revk/ESP32-Flasher/PCB/Flasher2/README.md

# Flasher2

## Trademark

This project is subject to the licence in the LICENCE file, and even if that says it is an open source project, you cannot sell boards or cases bearing the Andrews & Arnold Ltd name, the A&A logo, the registered trademark AJK logo or other registered trademarks, or any GS1 allocated EANs/barcode assigned to Andrews & Arnold Ltd.

## PCB Designs

These files are for use with [KiCAD](https://www.kicad.org).

- [Flasher](Flasher.kicad_pro)

## 3D

3D case designs are normally automatically created from the PCB so as to ensure correct details and placement of apertures, etc.

|Design|Bottom|Top|Combined|
|---|---|---|---|
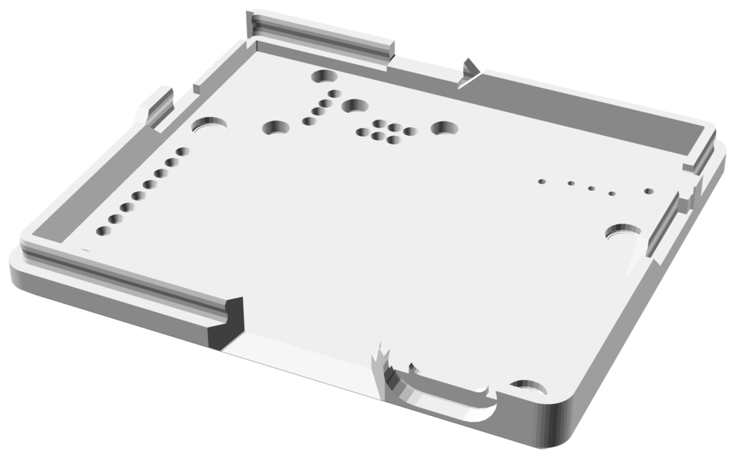
[picture p3: PCB/Flasher2/FlasherB.png]
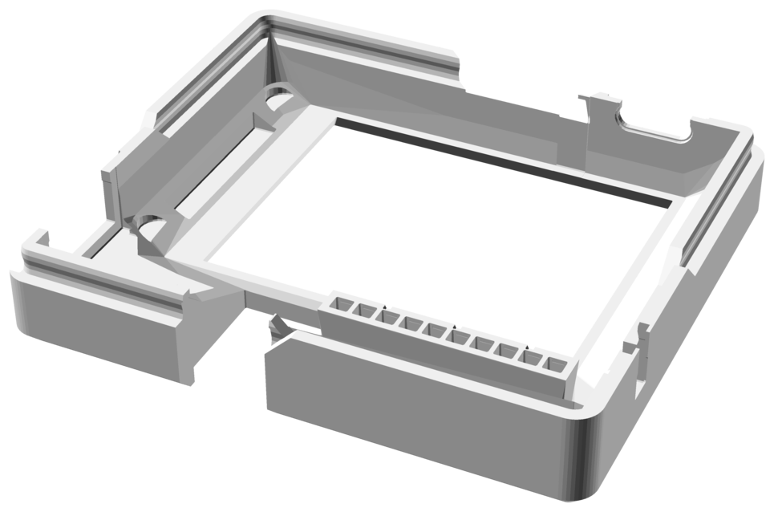
[picture p4: PCB/Flasher2/FlasherT.png]
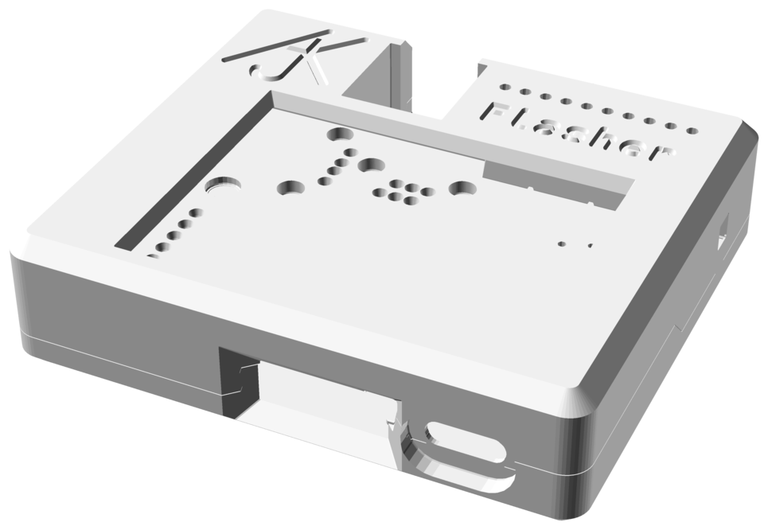
[picture p5: PCB/Flasher2/FlasherC.png]
|Flasher||||

## PCB Images

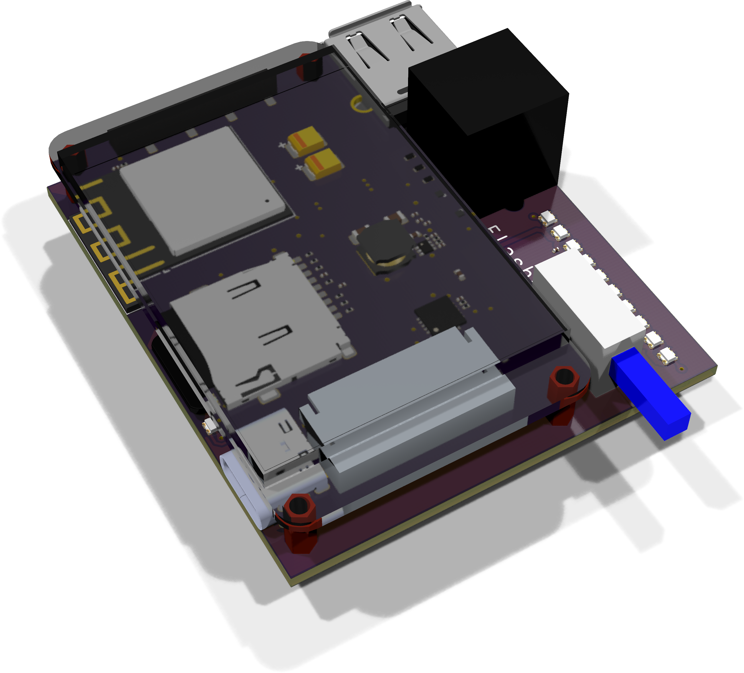
[picture p6: PCB/Flasher2/Flasher-90.png]
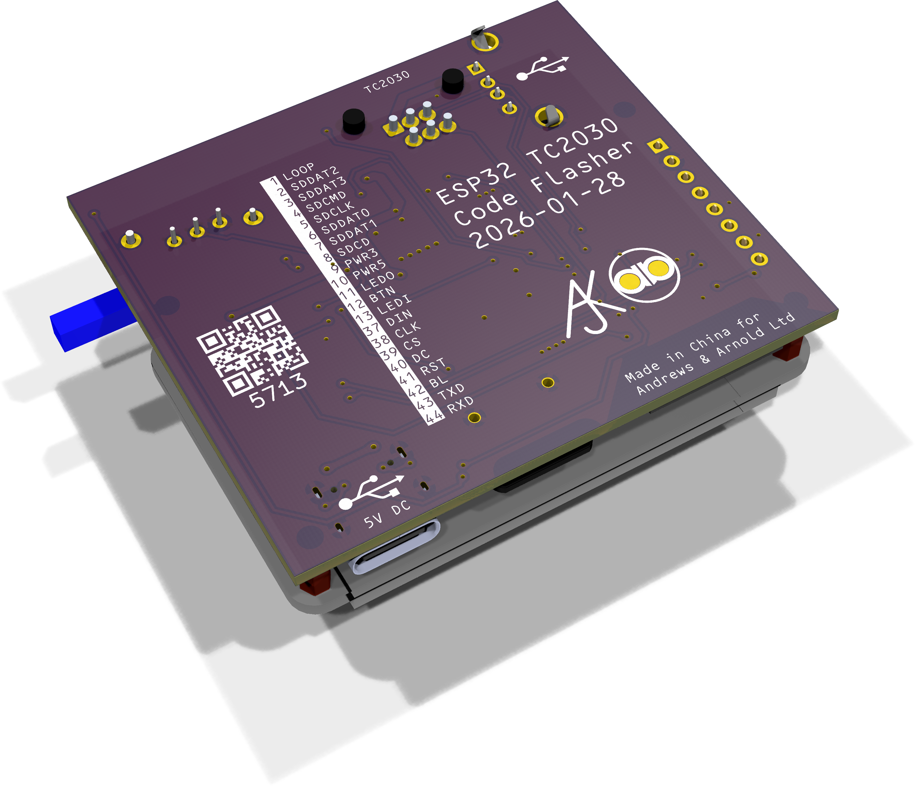
[picture p7: PCB/Flasher2/Flasher-bottom.png]

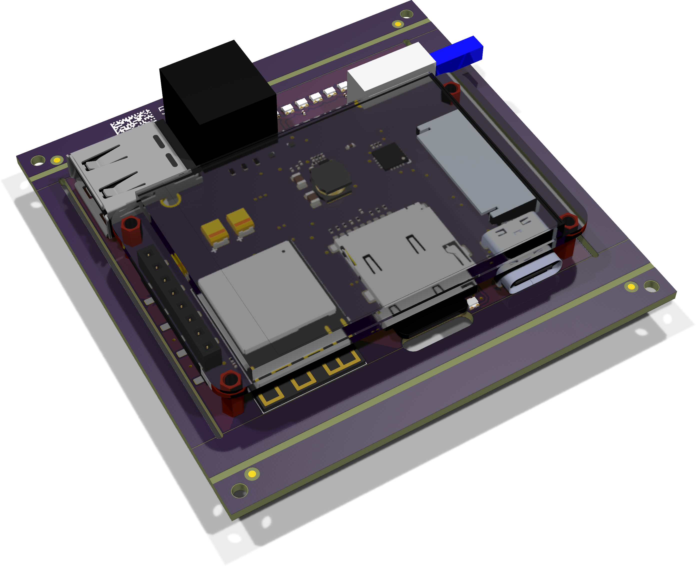
[picture p8: PCB/Flasher2/Flasher-panel.png]
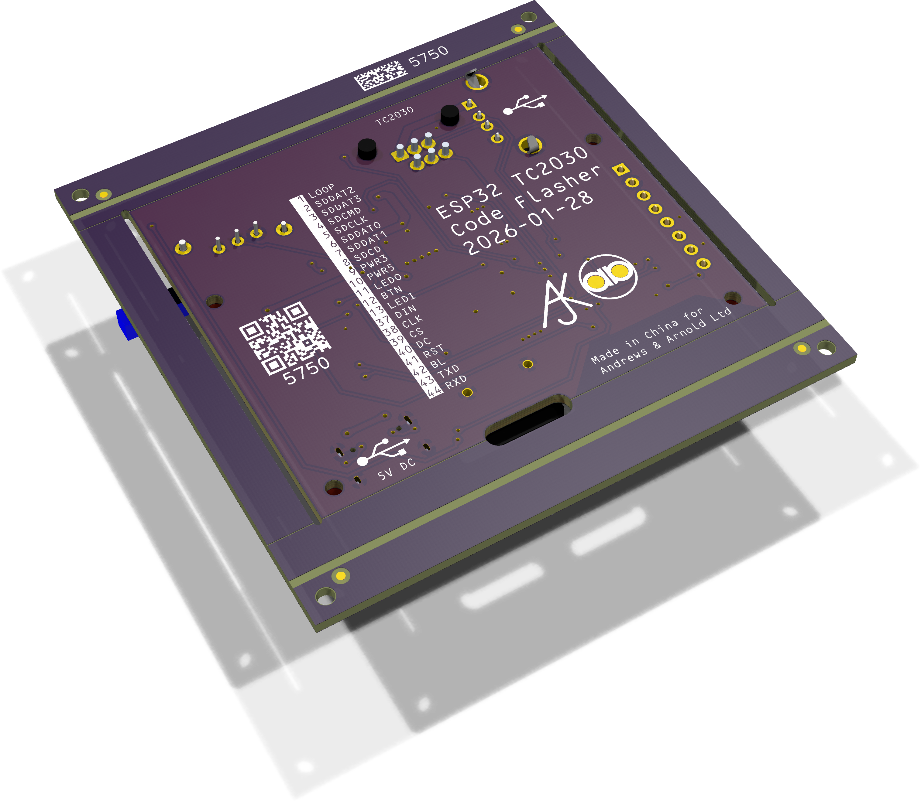
[picture p9: PCB/Flasher2/Flasher-panel-bottom.png]


---

*Auto generated README.md 2026-01-28T10:23:43*
