revk/ESP32-Flasher/PCB/Flasher/FlasherB.stl

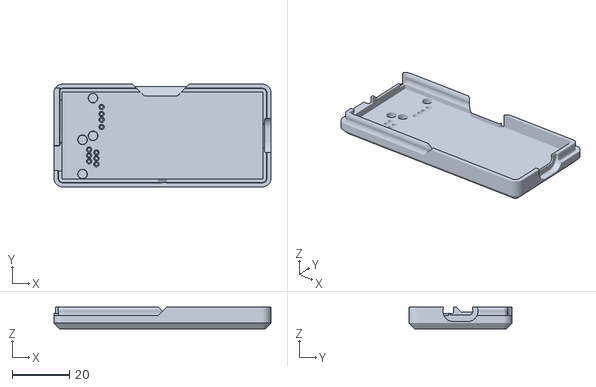
[picture p17: CAD file, 2026-01-18]
PCB/Flasher/FlasherB.stl
76.0 x 36.0 x 7.60
