revk/ESP32-Flasher/PCB/Flasher2/FlasherT.stl

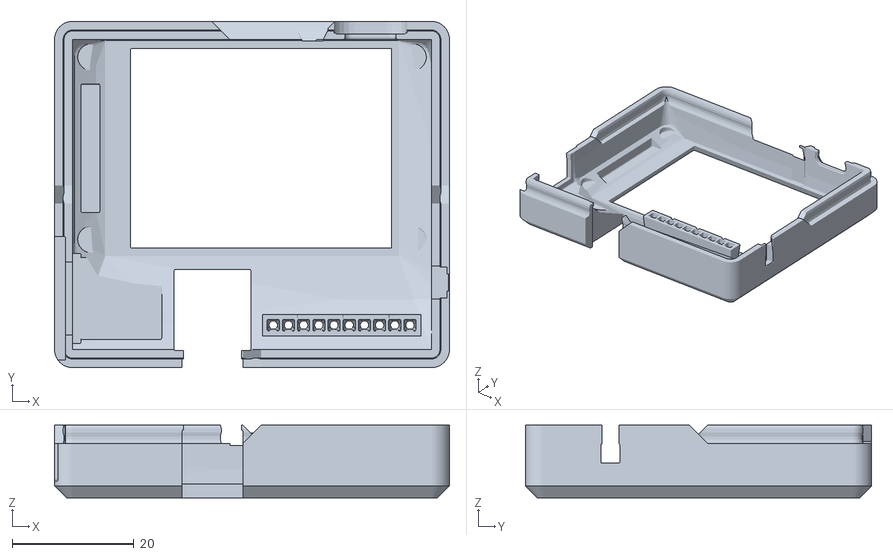
[picture p18: CAD file, 2026-01-28]
PCB/Flasher2/FlasherT.stl
65.0 x 57.0 x 12.0
