revk/ESP32-Flasher/PCB/Flasher/FlasherT.stl

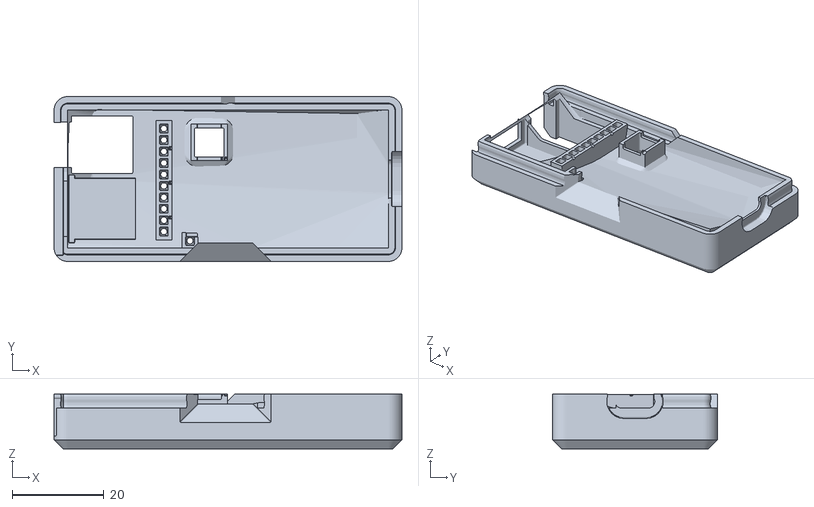
[picture p19: CAD file, 2026-01-18]
PCB/Flasher/FlasherT.stl
76.0 x 36.0 x 12.0
