revk/ESP32-Flasher/(list of files, cad)

Other CAD files:
PCB/Flasher/FlasherC.scad
PCB/Flasher/FlasherT.scad
PCB/Flasher2/FlasherB.scad
PCB/Flasher2/FlasherC.scad
PCB/Flasher2/FlasherT.scad
