revk/ESP32-Flasher/PCB/Flasher2/Flasher.kicad_pcb

## KiCad design PCB/Flasher2/Flasher.kicad_pcb (2026-01-28)

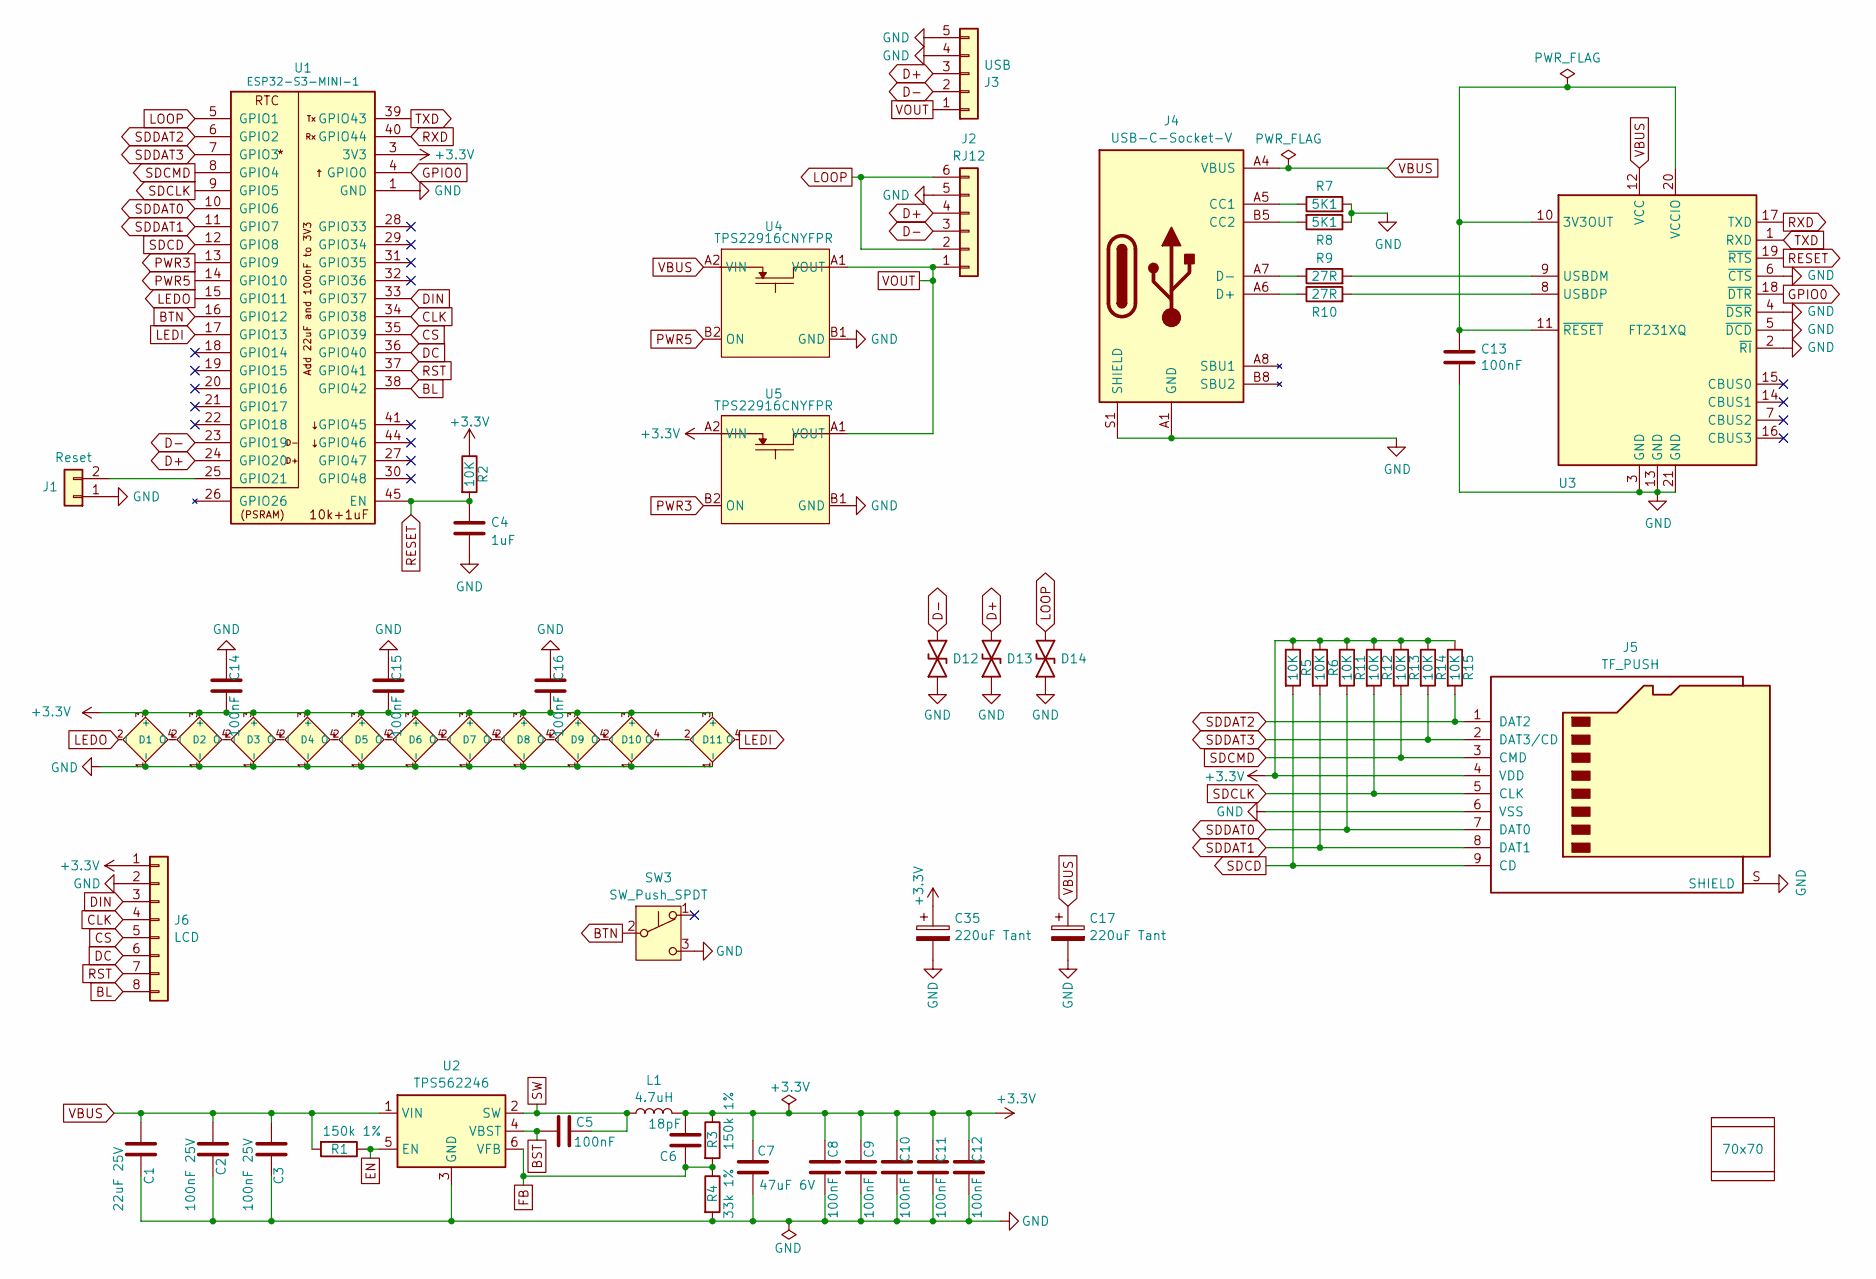
[picture p20: schematic Flasher.kicad_sch]

Parts:
C1: 22uF 25V; C_0805; MPN C45783
C2, C3: 100nF 25V; C_0402; MPN C56392
C4: 1uF; C_0201
C5, C8, C9, C10, C11, C12, C14, C15, C16: 100nF; C_0201; MPN C76934
C6: 18pF; C_0201; MPN C62164
C7: 47uF 6V; C_0805; MPN C16780
C13: 100nF; C_0201
C17, C35: 220uF Tant; CP_EIA-3528-21_Kemet-B; MPN C122649
D1, D2, D3, D4, D5, D6, D7, D8, D9, D10: XL-1010RGBC-WS2812B; SMD1615; MPN C5349954
D11: XL-1010RGBC-WS2812B; SMD1615-Side; MPN C5349954
D12, D13, D14: DFN1006-2L; MPN C5137770
J1: Reset; AA-Pad
J2: RJ12; RJ12_Horizontal; MPN C77859
J3: USB; USB_A_Horizontal; MPN C720525
J4: USB-C-Socket-V; USB-C-Socket-H; MPN C709357
J5: TF_PUSH; MPN C393941
J6: LCD; LCD2; MPN C42380985
L1: 4.7uH; L_5x5; MPN C307876
PCB1: 70x70; PCB7070
R1, R3: 150k 1%; R_0201; MPN C310173
R2, R5, R6, R11, R12, R13, R14, R15: 10K; R_0201; MPN C106225
R4: 33k 1%; R_0201; MPN C320835
R7, R8: 5K1; R_0201; MPN C270344
R9, R10: 27R; R_0201; MPN C273295
SW3: SW_Push_SPDT; PS-12E15; MPN C2884730
U1: ESP32-S3-MINI-1; MPN C3013941
U2: TPS562246; SOT-5x3-6; MPN C41833479
U3: FT231XQ; QFN-20-1EP_4x4mm_P0.5mm_EP2.5x2.5mm; Part No FT231XQ
U4, U5: TPS22916CNYFPR; WCSP-4-0.78x0.78; MPN C2655476
V2, V3: VCUT70N

Connections:
+3.3V: C6.2, C7.1, C8.2, C9.2, C10.2, C11.2, C12.2, C14.1, C15.1, C16.1, C35.1, D1.3 (+), D2.3 (+), D3.3 (+), D4.3 (+), D5.3 (+), D6.3 (+), D7.3 (+), D8.3 (+), D9.3 (+), D10.3 (+), D11.3 (+), J5.4 (VDD), J6.1, L1.2, R2.1, R3.1, R5.1, R6.1, R11.1, R12.1, R13.1, R14.1, R15.1, U1.3 (3V3), U5.A2 (VIN)
BL: J6.8, U1.38 (GPIO42)
BST: C5.1, U2.4 (VBST)
BTN: SW3.2 (B), U1.16 (GPIO12)
CLK: J6.4, U1.34 (GPIO38)
CS: J6.5, U1.35 (GPIO39)
D+: D13.2, J2.4, J3.3, U1.24 (GPIO20)
D-: D12.2, J2.3, J3.2, U1.23 (GPIO19)
DC: J6.6, U1.36 (GPIO40)
DIN: J6.3, U1.33 (GPIO37)
EN: R1.1, U2.5 (EN)
FB: C6.1, R3.2, R4.1, U2.6 (VFB)
GND: C1.2, C2.2, C3.2, C4.2, C7.2, C8.1, C9.1, C10.1, C11.1, C12.1, C13.2, C14.2, C15.2, C16.2, C17.2, C35.2, D1.1 (-), D2.1 (-), D3.1 (-), D4.1 (-), D5.1 (-), D6.1 (-), D7.1 (-), D8.1 (-), D9.1 (-), D10.1 (-), D11.1 (-), D12.1, D13.1, D14.1, J1.1, J2.5, J3.4, J3.5, J4.A1 (GND), J4.A12 (GND), J4.B1 (GND), J4.B12 (GND), J4.S1 (SHIELD), J5.6 (VSS), J5.S (SHIELD), J6.2, R4.2, R7.2, R8.1, SW3.3 (C), U1.1 (GND), U1.2 (GND), U1.42 (GND), U1.43 (GND), U1.46 (GND), U1.47 (GND), U1.48 (GND), U1.49 (GND), U1.50 (GND), U1.51 (GND), U1.52 (GND), U1.53 (GND), U1.54 (GND), U1.55 (GND), U1.56 (GND), U1.57 (GND), U1.58 (GND), U1.59 (GND), U1.60 (GND), U1.61 (GND), U1.62 (GND), U1.63 (GND), U1.64 (GND), U1.65 (GND), U2.3 (GND), U3.2 (~RI), U3.3 (GND), U3.4 (~DSR), U3.5 (~DCD), U3.6 (~CTS), U3.13 (GND), U3.21 (GND), U4.B1 (GND), U5.B1 (GND)
GPIO0: U1.4 (GPIO0), U3.18 (~DTR)
LEDI: D11.4 (O), U1.17 (GPIO13)
LEDO: D1.2 (I), U1.15 (GPIO11)
LOOP: D14.2, J2.2, J2.6, U1.5 (GPIO1)
unnamed: D1.4 (O), D2.2 (I)
unnamed: D2.4 (O), D3.2 (I)
unnamed: D3.4 (O), D4.2 (I)
unnamed: D4.4 (O), D5.2 (I)
unnamed: D5.4 (O), D6.2 (I)
unnamed: D6.4 (O), D7.2 (I)
unnamed: D7.4 (O), D8.2 (I)
unnamed: D8.4 (O), D9.2 (I)
unnamed: D9.4 (O), D10.2 (I)
unnamed: D10.4 (O), D11.2 (I)
unnamed: J1.2, U1.25 (GPIO21)
unnamed: J4.A5 (CC1), R7.1
unnamed: J4.B5 (CC2), R8.2
unnamed: J4.A6 (D+), J4.B6 (D+), R10.1
unnamed: J4.A7 (D-), J4.B7 (D-), R9.1
unnamed: C13.1, U3.10 (3V3OUT), U3.11 (~RESET), U3.20 (VCCIO)
unnamed: R9.2, U3.9 (USBDM)
unnamed: R10.2, U3.8 (USBDP)
PWR3: U1.13 (GPIO9), U5.B2 (ON)
PWR5: U1.14 (GPIO10), U4.B2 (ON)
RESET: C4.1, R2.2, U1.45 (EN), U3.19 (~RTS)
RST: J6.7, U1.37 (GPIO41)
RXD: U1.40 (GPIO44), U3.17 (TXD)
SDCD: J5.9 (CD), R5.2, U1.12 (GPIO8)
SDCLK: J5.5 (CLK), R12.2, U1.9 (GPIO5)
SDCMD: J5.3 (CMD), R13.2, U1.8 (GPIO4)
SDDAT0: J5.7 (DAT0), R11.2, U1.10 (GPIO6)
SDDAT1: J5.8 (DAT1), R6.2, U1.11 (GPIO7)
SDDAT2: J5.1 (DAT2), R15.2, U1.6 (GPIO2)
SDDAT3: J5.2 (DAT3/CD), R14.2, U1.7 (GPIO3)
SW: C5.2, L1.1, U2.2 (SW)
TXD: U1.39 (GPIO43), U3.1 (RXD)
VBUS: C1.1, C2.1, C3.1, C17.1, J4.A4 (VBUS), J4.A9 (VBUS), J4.B4 (VBUS), J4.B9 (VBUS), R1.2, U2.1 (VIN), U3.12 (VCC), U4.A2 (VIN)
VOUT: J2.1, J3.1, U4.A1 (VOUT), U5.A1 (VOUT)

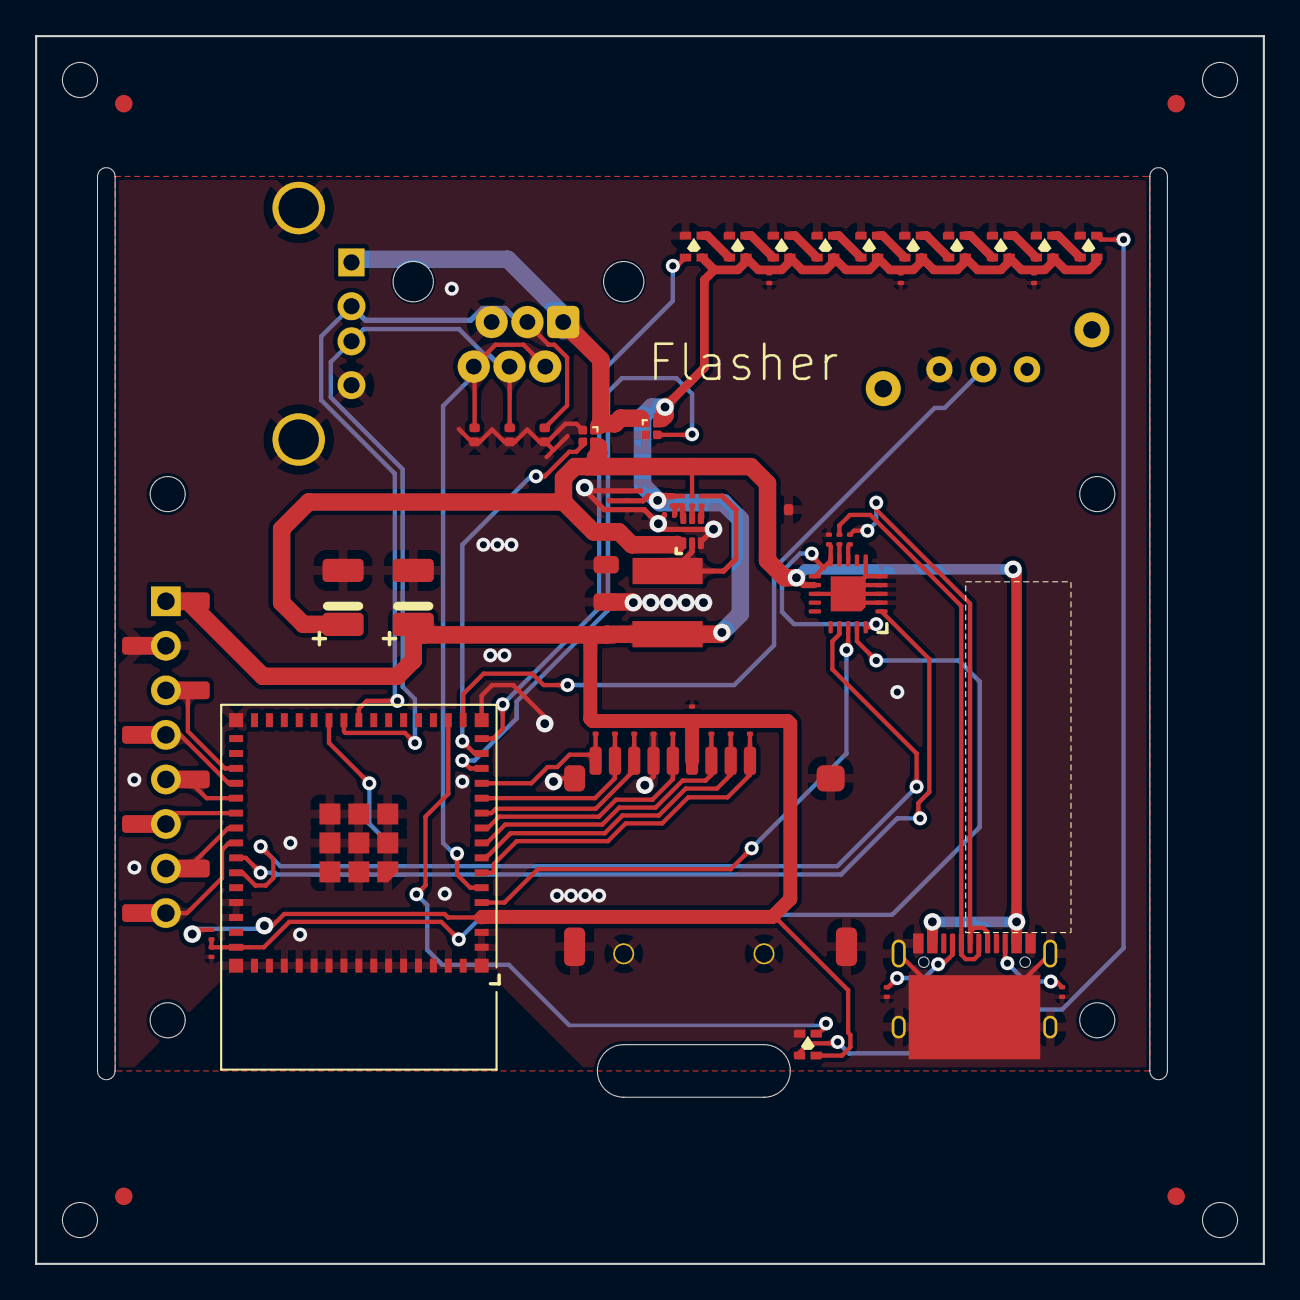
[picture p21: board Flasher.kicad_pcb from above]

Board: 2 copper layers, 70.0 x 70.0 mm, 63 parts (1 on the bottom side), 51 nets.
