revk/ESP32-Flasher/(commit log)

2025-09-13 Start PCb
    [Flasher.kicad_pcb, Flasher.kicad_sch]
2025-09-13 Started placement
    [Flasher.kicad_pcb, Flasher.kicad_sch, bom.csv, designators.csv, positions.csv]
2025-09-13 New tweaks
    [Flasher.kicad_pcb, Flasher.kicad_sch, FlasherB.scad, FlasherB.stl, FlasherT.scad, FlasherT.stl, bom.csv, designators.csv]
2025-09-14 New sockets
    [Flasher.kicad_pcb, Flasher.kicad_sch, bom.csv, designators.csv, positions.csv]
2025-09-14 Board ready
    [Flasher.kicad_pcb, Flasher.kicad_sch, FlasherB.scad, FlasherB.stl, FlasherT.scad, FlasherT.stl, bom.csv, designators.csv]
2025-09-16 Library update
    [Flasher.kicad_pcb]
2025-09-16 New render
    [FlasherB.scad, FlasherB.stl, FlasherT.scad, FlasherT.stl]
2025-09-16 Cleaner case
    [FlasherB.scad, FlasherB.stl, FlasherT.scad, FlasherT.stl]
2025-09-18 Cleanup case
    [FlasherB.scad, FlasherB.stl, FlasherT.scad, FlasherT.stl]
2025-09-23 SD and power
2025-09-23 Reverse USB, FFS
    [Flasher.kicad_pcb, Flasher.kicad_sch, FlasherB.scad, FlasherB.stl, FlasherT.scad, FlasherT.stl]
2025-09-24 Started on reset logic
    [Flasher.c]
2025-09-24 PCB update
    [Flasher.kicad_pcb, Flasher.kicad_sch, FlasherB.scad, FlasherB.stl, FlasherT.scad, FlasherT.stl, bom.csv, designators.csv]
2025-09-24 Thicker case
    [FlasherB.scad, FlasherB.stl, FlasherT.scad, FlasherT.stl]
2025-09-26 More on LED options
2025-09-26 Bad USB connection red LED
2025-09-26 no point re-flashing a definite fail
    [Flasher.c]
2025-09-27 button control
2025-09-27 LED tidy
2025-10-01 "check" and "voltage" added
2025-10-09 LED update
    [Flasher.kicad_pcb, Flasher.kicad_sch, FlasherB.scad, FlasherB.stl, FlasherT.scad, FlasherT.stl, bom.csv, positions.csv]
2025-10-09 New LED
    [Flasher.kicad_pcb, Flasher.kicad_sch, FlasherB.scad, FlasherB.stl, FlasherT.scad, FlasherT.stl]
2025-10-12 Re render
    [FlasherB.scad, FlasherB.stl, FlasherT.scad, FlasherT.stl]
2025-10-12 LED 3D update
    [FlasherB.scad, FlasherT.scad, FlasherT.stl]
2025-10-22 Render and space LEDs
    [FlasherB.scad, FlasherB.stl, FlasherC.scad, FlasherT.scad, FlasherT.stl]
2025-11-21 fix: flasher needing reset every other board, S'Oh
    [Flasher.c]
2026-01-16 New board design started
    [4_bom.csv, 4_designators.csv, 4_positions.csv, Flasher.kicad_pcb, Flasher.kicad_sch, FlasherB.scad, FlasherB.stl, FlasherC.scad]
2026-01-17 Started Flasher 2 layout
    [Flasher.kicad_pcb, Flasher.kicad_sch]
2026-01-17 Working on case
    [FlasherT.stl, bom.csv, designators.csv, positions.csv]
2026-01-19 As ordered
    [Flasher.kicad_pcb, Flasher.kicad_sch, FlasherB.scad, FlasherC.scad, FlasherT.scad, FlasherT.stl, bom.csv, positions.csv]
2026-01-28 New button
    [FlasherB.scad, FlasherC.scad, FlasherT.scad, FlasherT.stl]
2026-01-28 Minor tweaks
    [Flasher.kicad_pcb, FlasherB.scad, FlasherC.scad, FlasherT.scad, FlasherT.stl, positions.csv]
